AdhamHamdy03/Final-Project-Bachelor-DTMF-Ultrasound-Autonomous-Robot-etc-./rendu 1 /BASE_GR11.pdf

## BASE_GR11

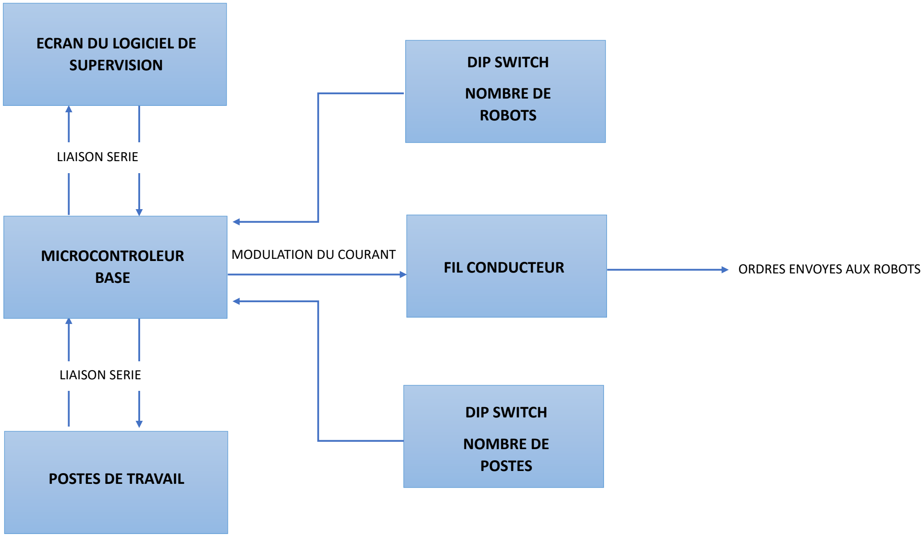
[picture p1: figure]
MICROCONTROLEUR BASE; ECRAN DU LOGICIEL DE SUPERVISION; POSTES DE TRAVAIL; FIL CONDUCTEUR; MODULATION DU COURANT; ORDRES ENVOYES AUX ROBOTS; LIAISON SERIE; DIP SWITCH; NOMBRE DE POSTES; NOMBRE DE ROBOTS
