AdhamHamdy03/Final-Project-Bachelor-DTMF-Ultrasound-Autonomous-Robot-etc-./rendu 1 /POSTE_GR11.pdf

# Poste_Gr11

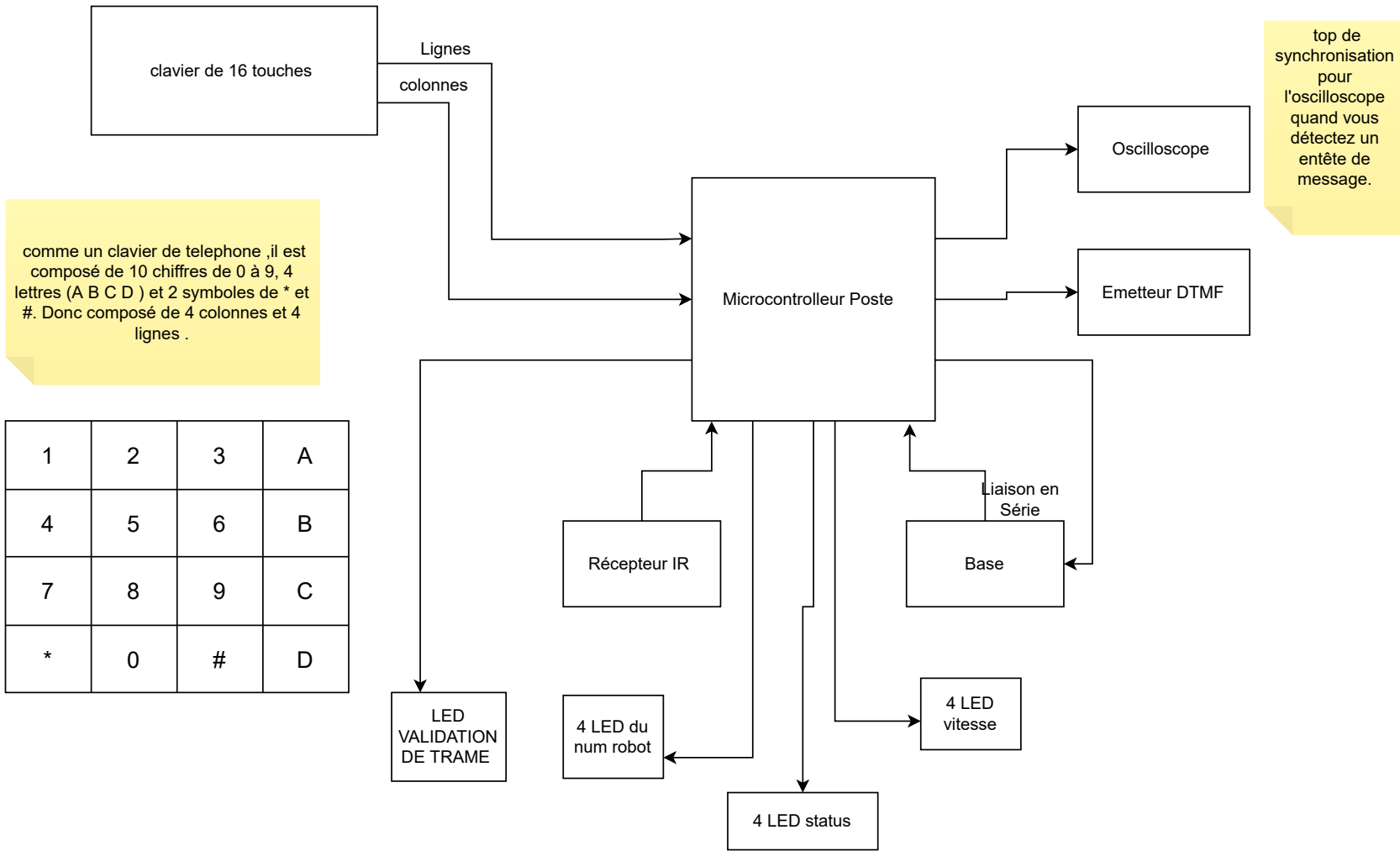
[picture p2: figure]
Microcontrolleur Poste; clavier de 16 touches; Lignes; colonnes; Emetteur DTMF; Récepteur IR; Base; Liaison en Série; LED VALIDATION DE TRAME; 4 LED du num robot; Oscilloscope; top de synchronisation pour l'oscilloscope quand vous détectez un entête de message.; comme un clavier de telephone ,il est composé de 10 chiffres de 0 à 9, 4; #. Donc composé de 4 colonnes et 4 lignes .; 4 LED status; 4 LED vitesse

lettres (A B C D ) et 2 symboles de * et

status :
0x8 "disponible" ,0x4 "enlèvecolis", 0x2 "colispris", 0x1 "livraison"
