AdhamHamdy03/Final-Project-Bachelor-DTMF-Ultrasound-Autonomous-Robot-etc-./rendu 1 /STATUS_GR11.pdf

STATUS_GR11 | Code C associé au grafcet :
| void status_grafcet(void){
| static unsigned char pos_jeton = 1;
| switch(pos_jeton)
| {
| case 1: // Status « disponible »- attente d’une demande de livraison
| if(flag_delivery_assigned){ pos_jeton++; }
| break;
| case 2: // Status « enlèvecolis » – en route au poste de pickup colis
| if(Robot_at_poste_pickup) { stop(); }
| else { move(); }
| if(flag_leave_pickup) { pos_jeton++;}
| break;
| case 3: // Status « colispris » – attente transmission du poste dropoff
| move();
| if(flag_assigned_dropoff) { assign_dropoff_poste(); pos_jeton++;}
| break;
| case 4: // Status « livraison » – en route au poste de dropoff colis
| if(Robot_at_poste_dropoff) { stop(); }
| else { move(); }
| if(flag_leave_dropoff) { pos_jeton = 1; }
| }
| }

move

flag_leave_dropoff

move | stop

!(Robot_at_poste_dropoff) Robot_at_poste_dropoff

flag_leave_pickup

assign_dropoff_poste

1

2

3

4

flag_delivery_assigned

move | stop

!(Robot_at_poste_pickup) Robot_at_poste_pickup

move
