AdhamHamdy03/Final-Project-Bachelor-DTMF-Ultrasound-Autonomous-Robot-etc-./rendu 2/WBS_GR11.pdf

# Tâches

# Lots de tâches

# Sous-projets

Projet | Infrastructure Autonome de livraison

Préparation

1er rendu

# SUPER_GR11 ROBOT_GR11 COM_GR11 POSTE_GR11 BASE_GR11

STATUS_GR11 PHYSIQUE_GR11 Validation des documents Rendu des documents a l'équipe pédagogique

Livrable : Documents qui sert à préparer le 2ème rendu

2ème rendu Bilan ES Base Bilan ES Poste Bilan ES Robot WBS Matrice RACI Validation des documents Rendu des documents a l'équipe pédagogique

Livrable : Organisation du projet et répartition des tâches entre les membres de l'équipe

Base
Liaison série avec la Supervision Choix du protocole de communication Initialisation et configuration des registres Gestion des interruptions et buffers Validation par simulation série sur KEIL

Livrable : Visualisation du status de chaque robot et requêtes des postes

Liaison série avec les Postes Choix du protocole de communication

Initialisation et configuration des registres Gestion des interruptions et buffers Tests avec simulateur de poste ou terminal série

Livrable : Routine de demande informations aux postes

Emission signal modulé dans le fil Schéma électrique Conception du circuit émetteur (oscillateur + amplificateur) Choix de la fréquence de modulation Génération du signal via PWM microcontrôleur Codage des instructions Test sur fil conducteur avec oscilloscope Vérification de la lisibilité et de l’intégrité du signal Livrable : Signal de commande des robots

Poste

Liaison série avec la base Choix du protocole de communication

Initialisation et configuration des registres Gestion des interruptions et buffers Tests avec simulateur liaison série sur KEIL

Livrable : Status des robots et requêtes des postes

Réception IR
Schéma électrique Choix du capteur Montage physique orienté vers la trajectoire du robot Filtrage matériel (fréquence porteuse) Décodage du signal IR (ID, vitesse, status robot) Validation de la trame (entête, checksum) Test en conditions réelles avec robot approchant Livrable : Signal IR capté qui vient du robot et qui indique son ID, sa vitesse et son status

Émission DTMF

Schéma électrique Codage signal DTMF sur microcontrôlleur du poste

Implémentation de la génération DTMF par interpolation

Tests de reconnaissance côté base avec décodeur Livrable : Signal DTMF à envoyé au robot avec le numéro de poste encodé

Robot Assamblage robot Schéma électrique et câblage Conception du châssis Emplacement des capteurs (IR, bobines, DTMF, proxymetre) Fixation des modules (IR, moteurs, labdec) Test robustesse

Livrable : Structure physique du robot

# Alimentation Choix composants Schéma électrique Convertisseur de tension

Système coupe de poing Mesure de tension et validation

Livrable : Alimentation des modules du robot

Capteur inductif - Suivi du fil Conception des bobines de réception

Schéma électrique Câblage du circuit Lecture du signal modulé (via ADC) Synchronisation de la prise de mesure avec le microcontrôleur Calcul de l'amplitude du signal -> calcul de la distance Algorithme de suivi ligne (centrage, virage) Test sur piste avec fil au sol Livrable : Distance entre le fil et le robot, à utiliser pour le piloter

Système contrôle du moteur/des roues Choix des moteurs (DC, pas-à-pas) Dimensionnement puissance, couple

Schéma électrique Pilotage par H-Bridge Génération PWM et commande direction Régulation vitesse/direction (PID si nécessaire) Développement du code embarqué

Tests sur simulateur et sur robot après implémentation

Livrable : Pilotage du robot

Mésure de la distance parcouroue Choix de carte FPGA

Liaision SPI avec le microcontrôlleur du robot Codeurs incrémentaux des moteurs Programmation de la carte FPGA et du microcontrôlleur Tests sur simulateur série KEIL et simulateur Vivado

Livrable : Distance parcourue

Système détection obstacles Schéma électrique Choix du capteur Fixation frontale sur robot Lecture périodique du capteur Définition seuil critique de distance Déclenchement arrêt ou évitement Haut Parleur - message audio de prevention

Implémentation routine d’arrêt d’urgence

Tests sur simulateur KEIL

Livrable : Prevention des accidents sur la route

Émission IR
Schéma électrique Choix LED IR (intensité, angle émission) Choix Fréquence de modulation Création de trame à envoyer (entête, ID, vitesse, status) Émission cyclique (timer) Synchronisation de la prise de mesure avec le microcontrôleur Tests sur simulateur KEIL

Livrable : Signal IR envoyé au poste avec l'ID, la vitesse et le status du robot

Réception DTMF

Schéma électrique
Intégration circuit de décodage DTMF Détection de tonalités (via interruption ou polling) Décodage vers commande de destination

Stockage ou traitement immédiat Test du module

Livrable : reconnaissance du poste qu'il détecte
