AdhamHamdy03/Final-Project-Bachelor-DTMF-Ultrasound-Autonomous-Robot-etc-./schemas 2/GR11_SchemaElec.pdf

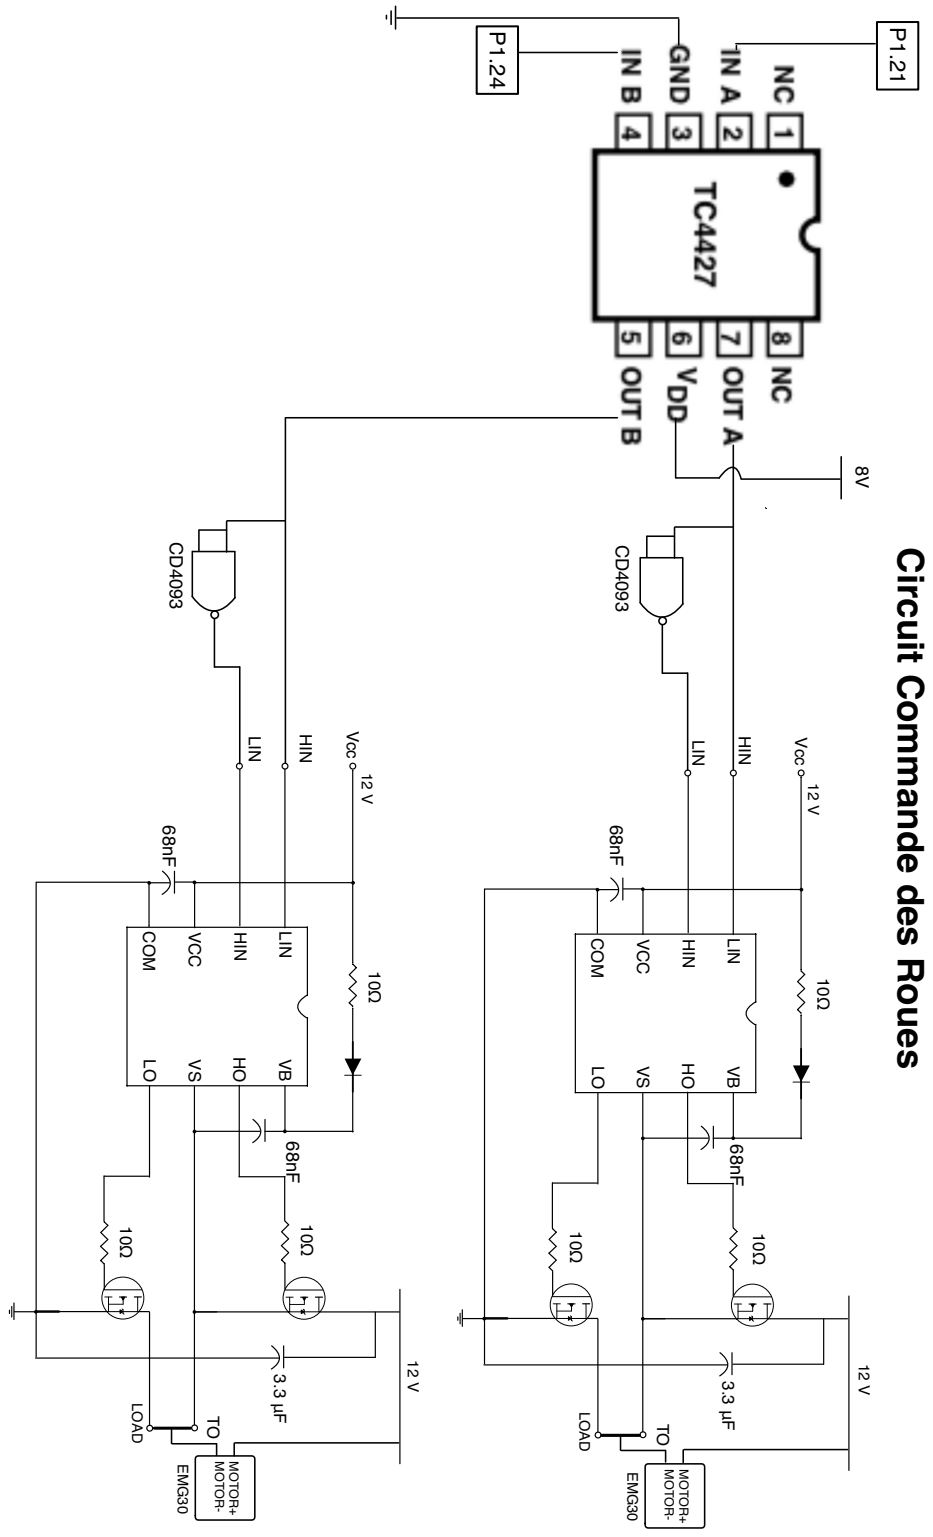
[picture p3: page 1]
COM; VCC; HIN; LIN; Vcc; LOAD; EMG30; MOTOR-; MOTOR+

P1.21 Circuit Commande des Roues

## Circuit Courant modulé

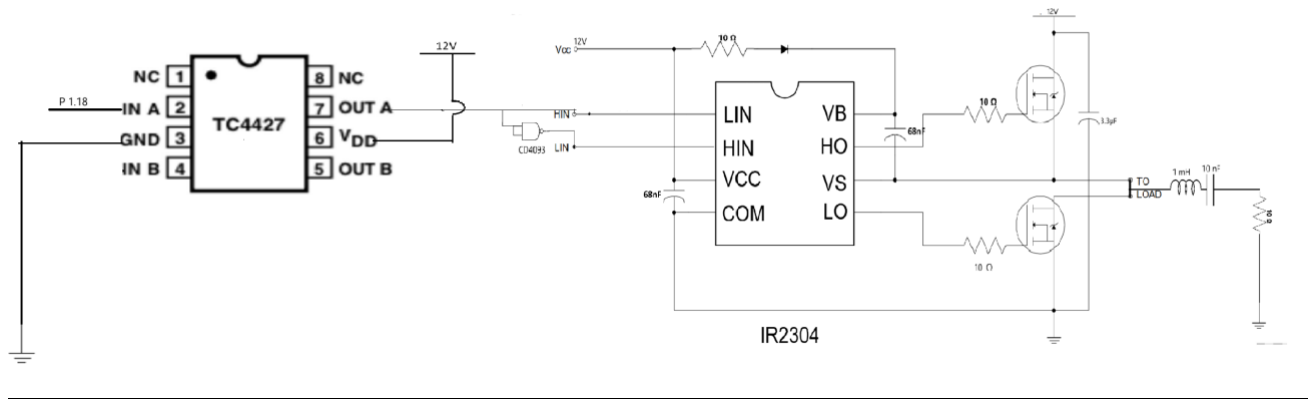
[picture p4: figure]

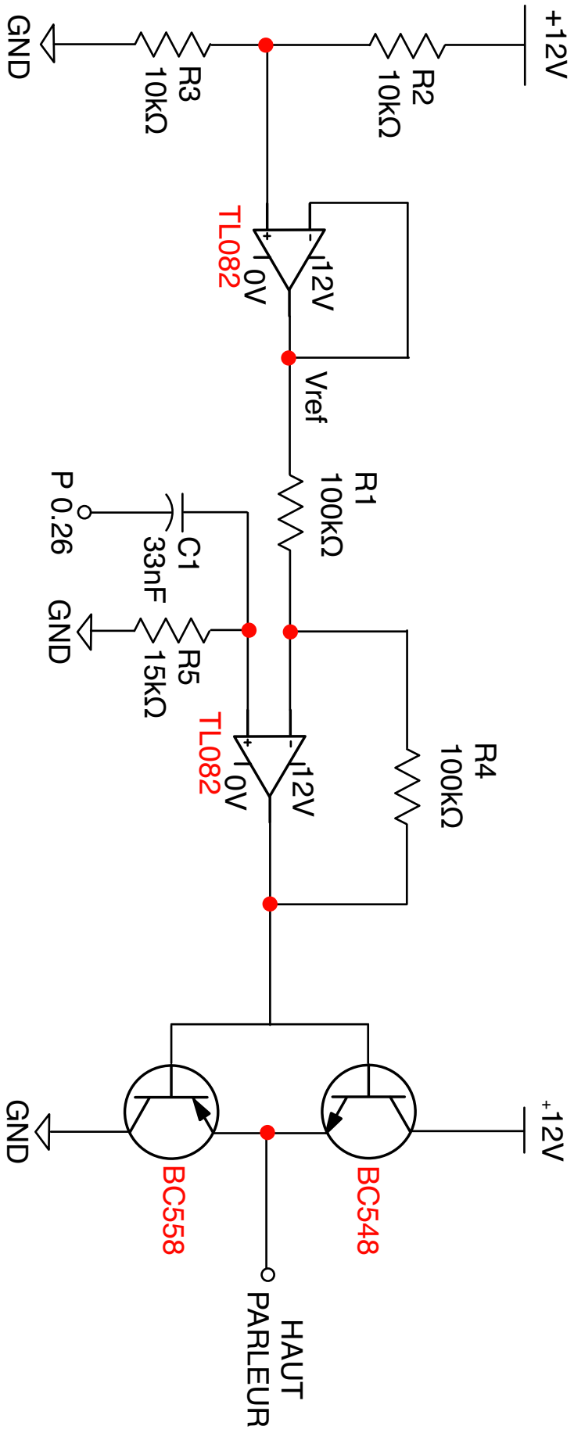
[picture p5: figure]
GND; HAUT; PARLEUR; Vref

## Emission DTMF

# Émission Infrarouge

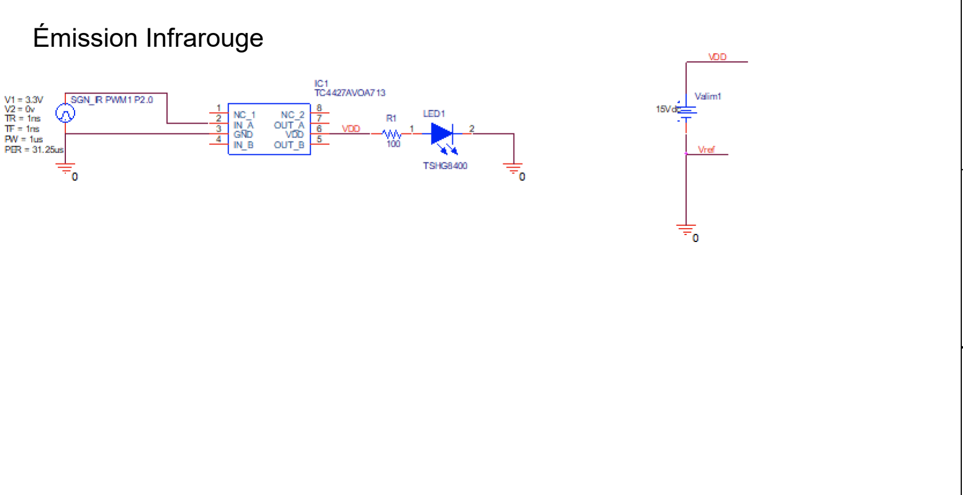
[picture p6: page 4]

# Réception Infrarouge

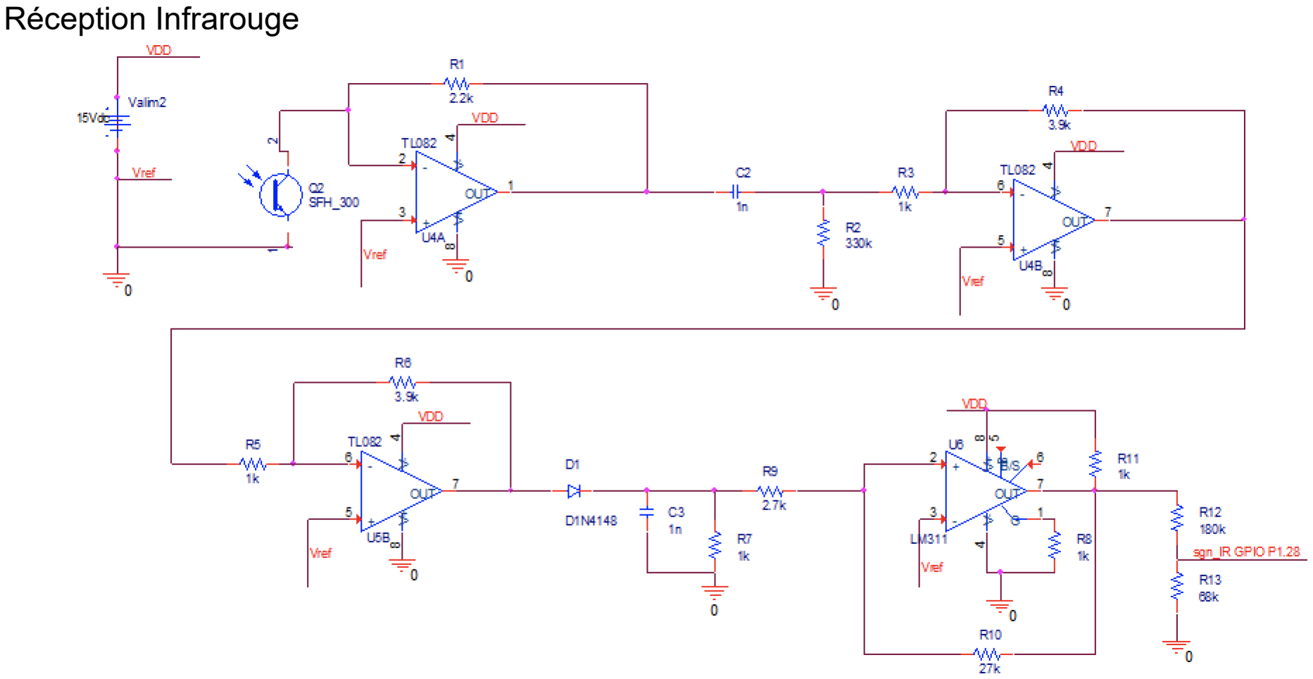
[picture p7: page 5]

# Mesure de distance

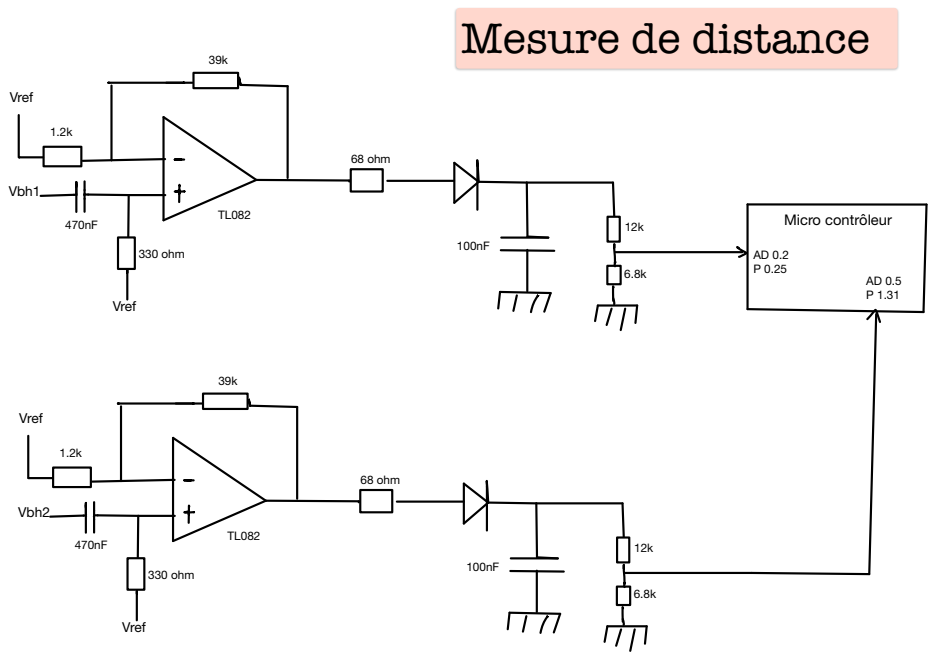
[picture p8: page 6]
Micro contrôleur; Vref; Vbh1; 330 ohm; 68 ohm; Vbh2

### Xor1

# Orientation du robot par rapport

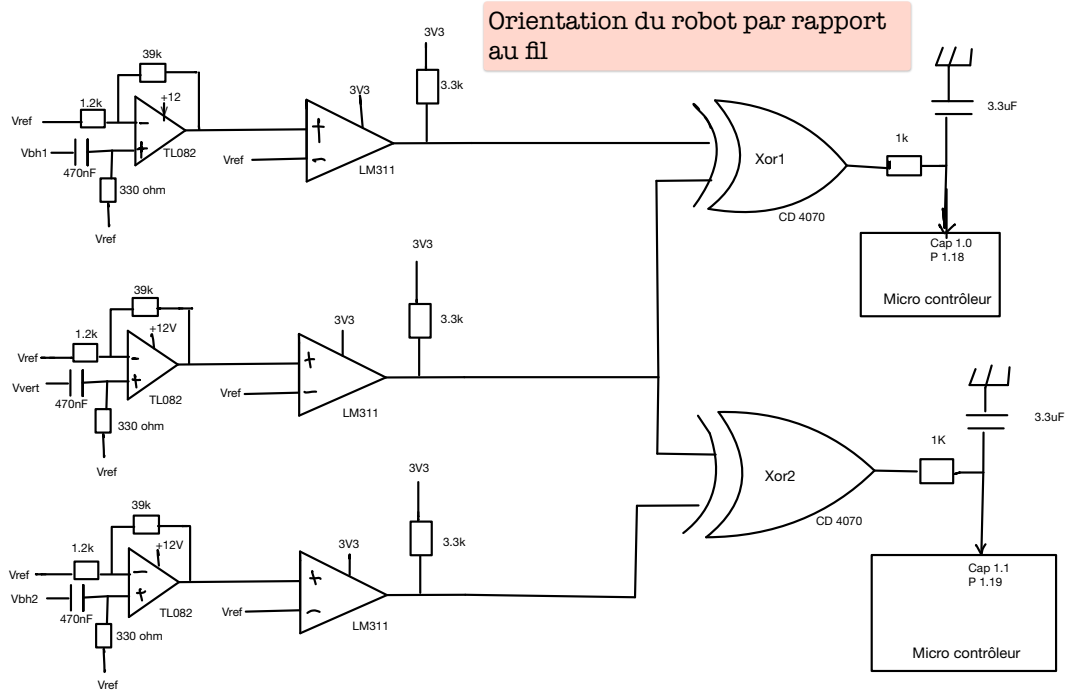
[picture p9: page 7]
Cap 1.0 P 1.18; Cap 1.1 P 1.19; Micro contrôleur; 330 ohm; Vbh1; Vref; Vbh2; Vvert; Xor2; au fil

# Lecture du message reçu par la base

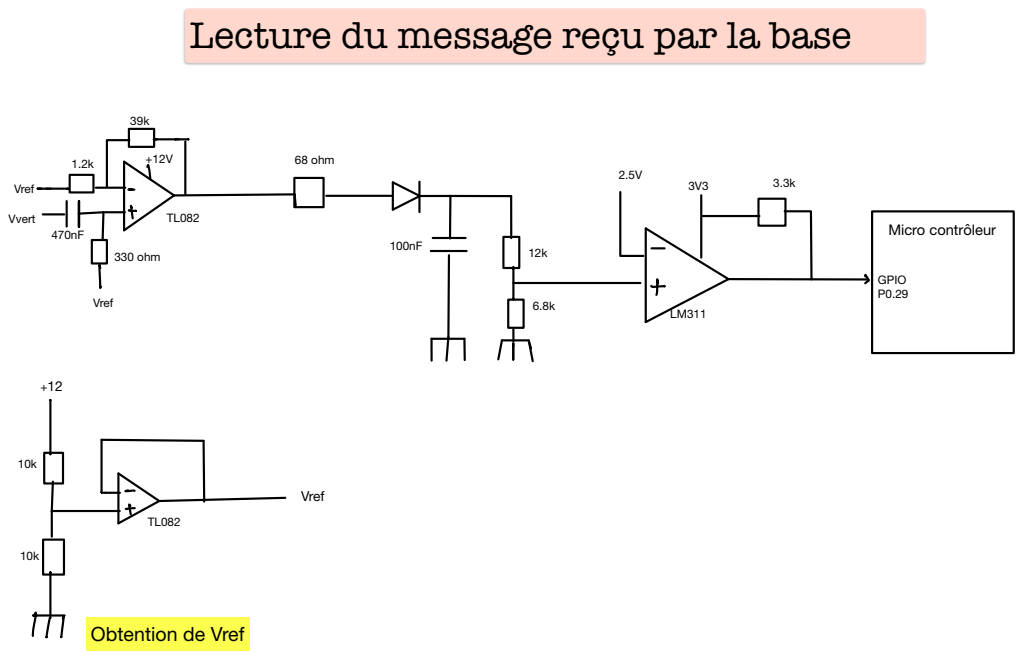
[picture p10: page 8]
330 ohm; Vref; Vvert; 68 ohm; Micro contrôleur; GPIO P0.29

Obtention de Vref

## Réception DTMF :

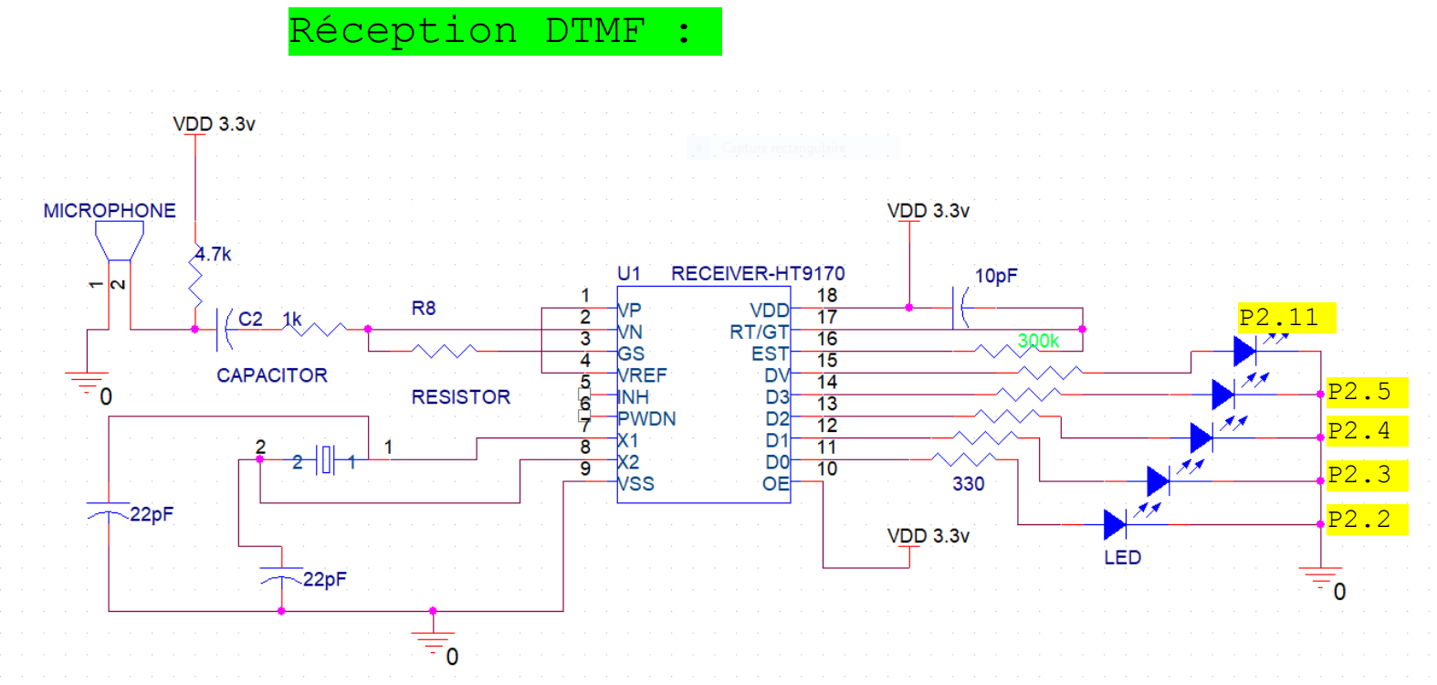
[picture p11: page 9]

P2.11

P2.5

P2.3

P2.2

P2.4

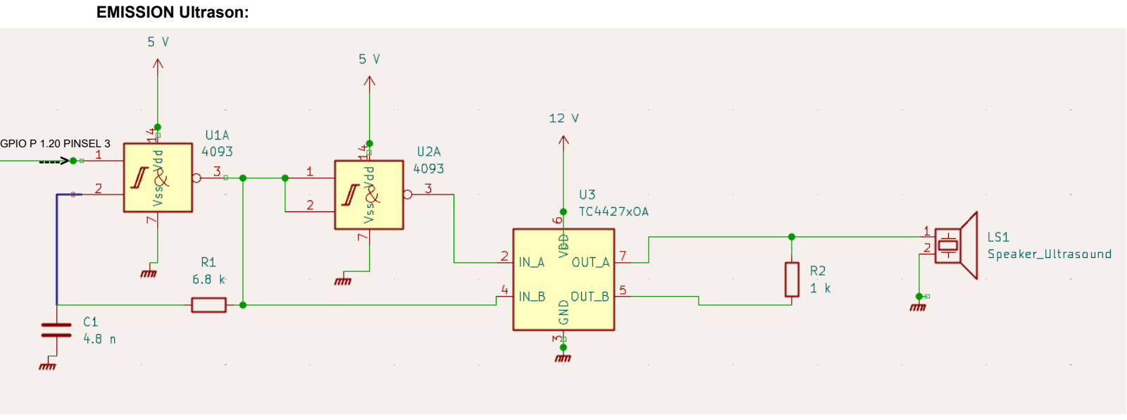
[picture p12: page 10]

EMISSION Ultrason:

GPIO P 1.20 PINSEL 3
---->

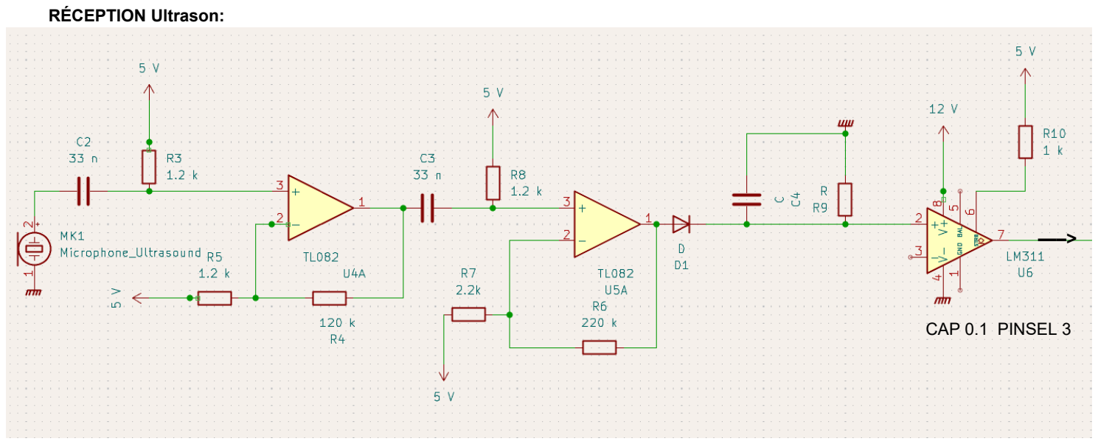
[picture p13: page 11]

RÉCEPTION Ultrason:

—–>

CAP 0.1 PINSEL 3

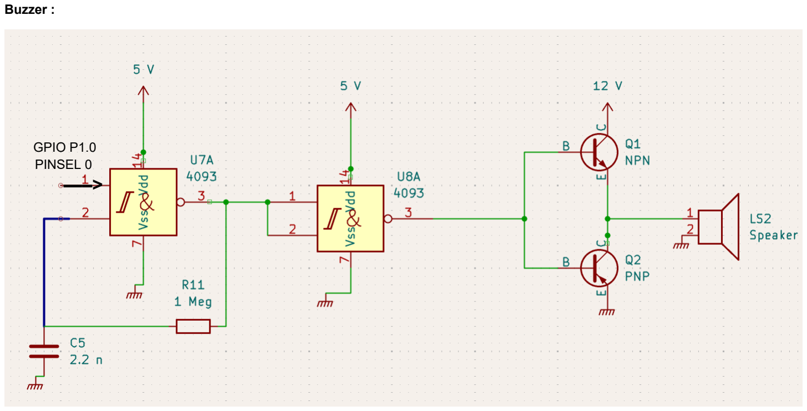
[picture p14: page 12]

Buzzer :

GPIO P1.0
PINSEL 0
—–>
