AdhamHamdy03/Final-Project-Bachelor-DTMF-Ultrasound-Autonomous-Robot-etc-./schema et travail/reception dtmf jana .pptx

Réception DTMF :

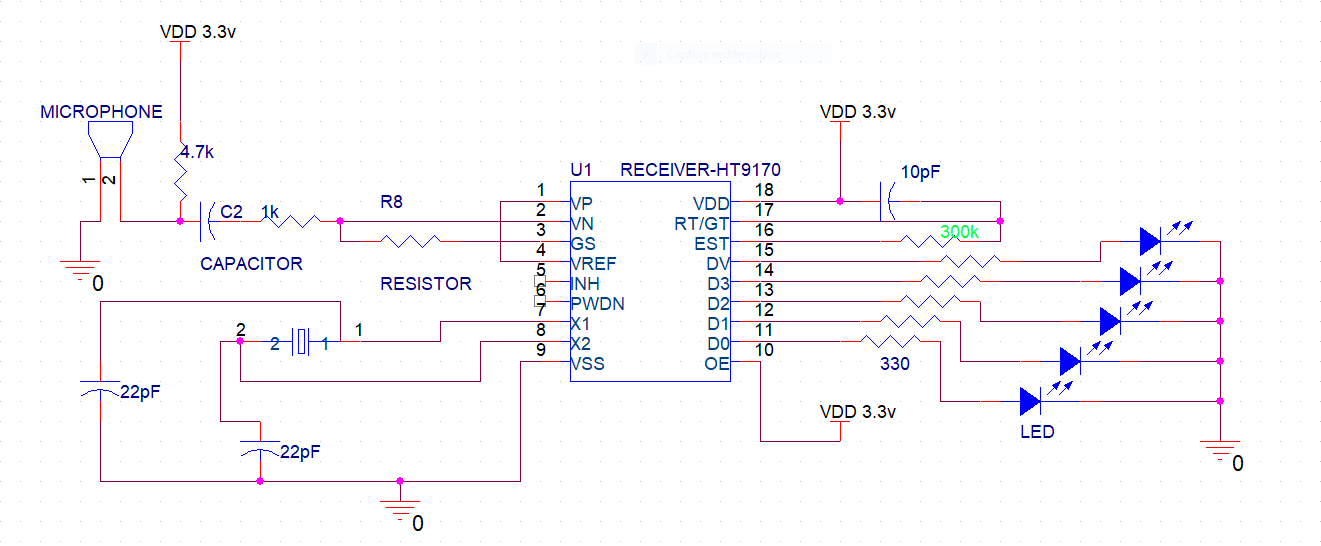
[picture p15: figure]

P2.11

P2.5

P2.4

P2.3

P2.2

## Schéma block Emission DTMF :

Filtrage des bases frequences jusqu’à 5 KHz

Amplification de tension de gain =3

Amplification de puissance

Signal sortie et haut parleur

Signal d’entrée

## Schema Etat reception DTMF

READ_HASH

READ_A

Code==12

Code==11

Code<=10

Code==13

READ_STAR

READ_DIGIT

## Reception DTMF

Signal reçue

Microphone

Filtrage

Message codé en 4 bits

P2.2
P2.3
P2.4
P2.5

Amplification
Gain =100

Décodage

Validation de trame

P2.11
