AdhamHamdy03/Final-Project-Bachelor-DTMF-Ultrasound-Autonomous-Robot-etc-./rendu 1 /COM_GR11.pdf

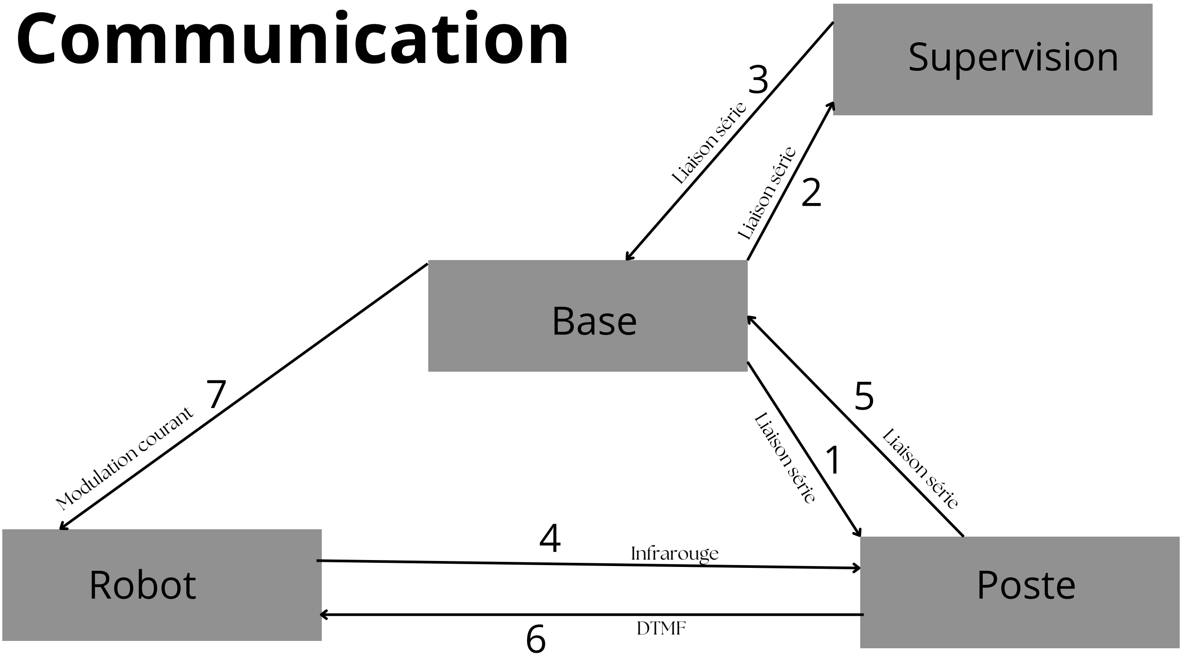
[picture p16: figure]
Base; Robot; Supervision; Poste; Liaison série; Infrarouge; DTMF; Modulation courant; Communication

1
2
3

4
5

6

7

La base interroge le poste sur son état

Transmission des informations sous la forme d’un message du type PxxRyvZ pour l’affichage de l’écran de supervision
L’écran de supervision envoie à la base des messages d’attribution de mission du type RxxPyy-Pzz et la base récupère les vitesses et numéros de robots affichés (RxxVyy)

Transmission de l’identifiant du robot au poste sous forme d’un trame infrarouge

Le poste génère un code DTMF permettant à un robot qui lui passe devant d’identifier son numéro

Réponse du poste à la base avec la transmission des informations du robot

En modulant le courant, la base va avertir les robots et leurs donner des missions ainsi qu’assurer l’asservissement du trajectoire et donc le suivi du fil
