AdhamHamdy03/Final-Project-Bachelor-DTMF-Ultrasound-Autonomous-Robot-etc-./rendu 1 /PHYSIQUE_GR11.pdf

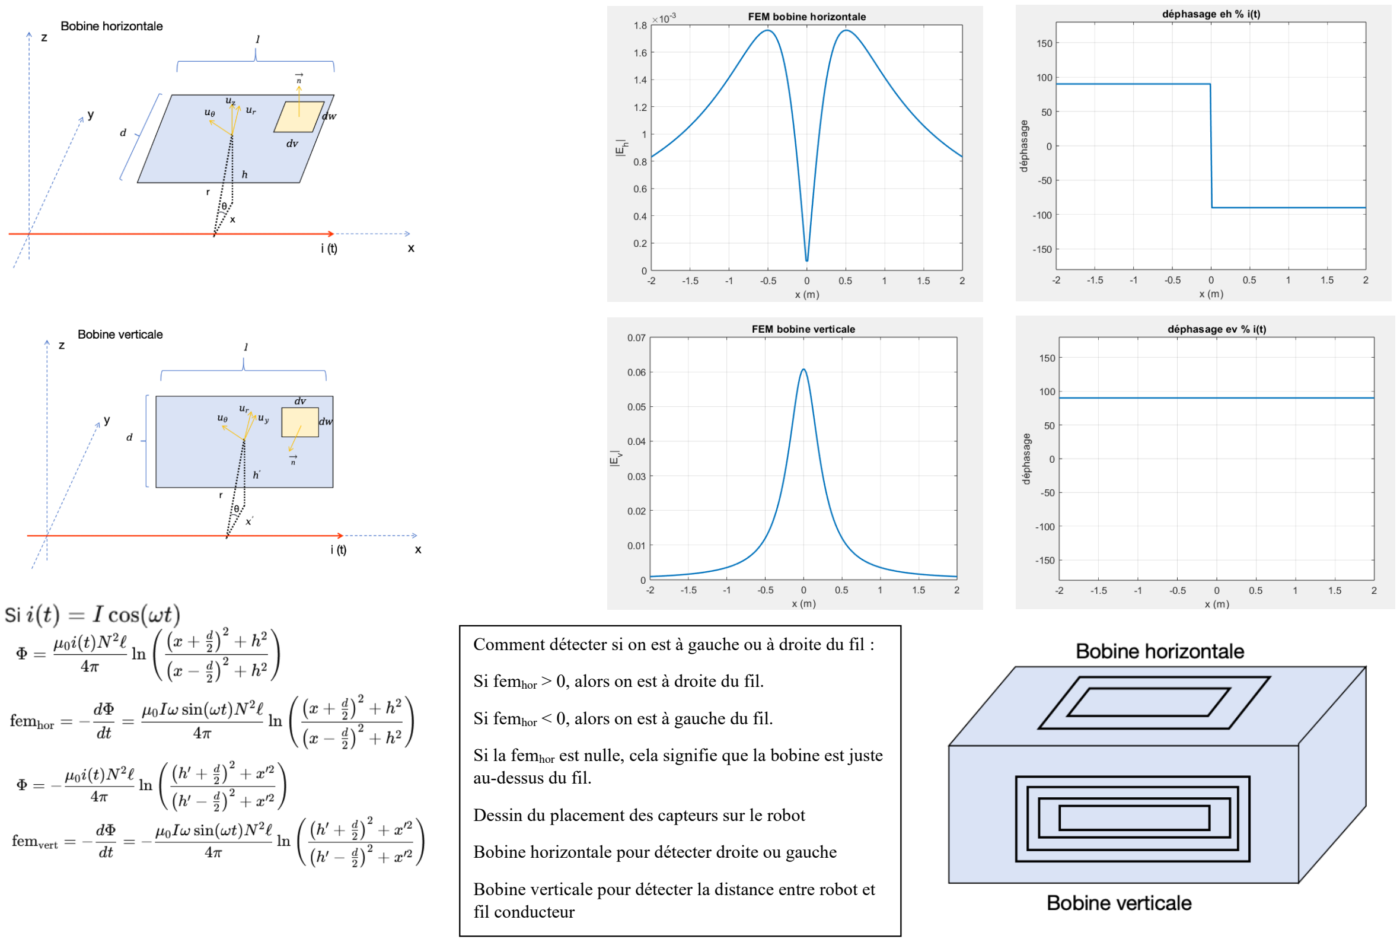
[picture p17: page 1]

Comment détecter si on est à gauche ou à droite du fil :

Si femhor > 0, alors on est à droite du fil.

Si femhor < 0, alors on est à gauche du fil.

Si la femhor est nulle, cela signifie que la bobine est juste au-dessus du fil.

Dessin du placement des capteurs sur le robot

Bobine horizontale pour détecter droite ou gauche

Bobine verticale pour détecter la distance entre robot et fil conducteur

### Démarche pour calculer :

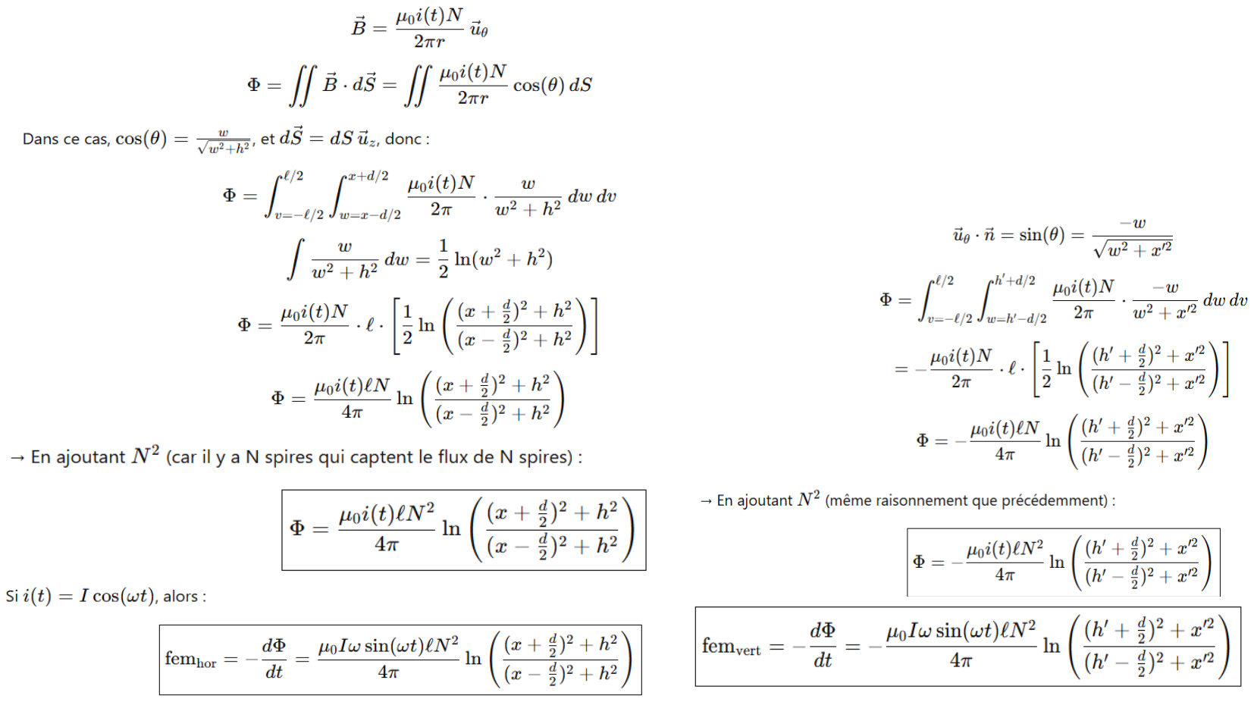
[picture p18: figure]
