AdhamHamdy03/Final-Project-Bachelor-DTMF-Ultrasound-Autonomous-Robot-etc-./rendu 1 /SUPER_GR11.pdf

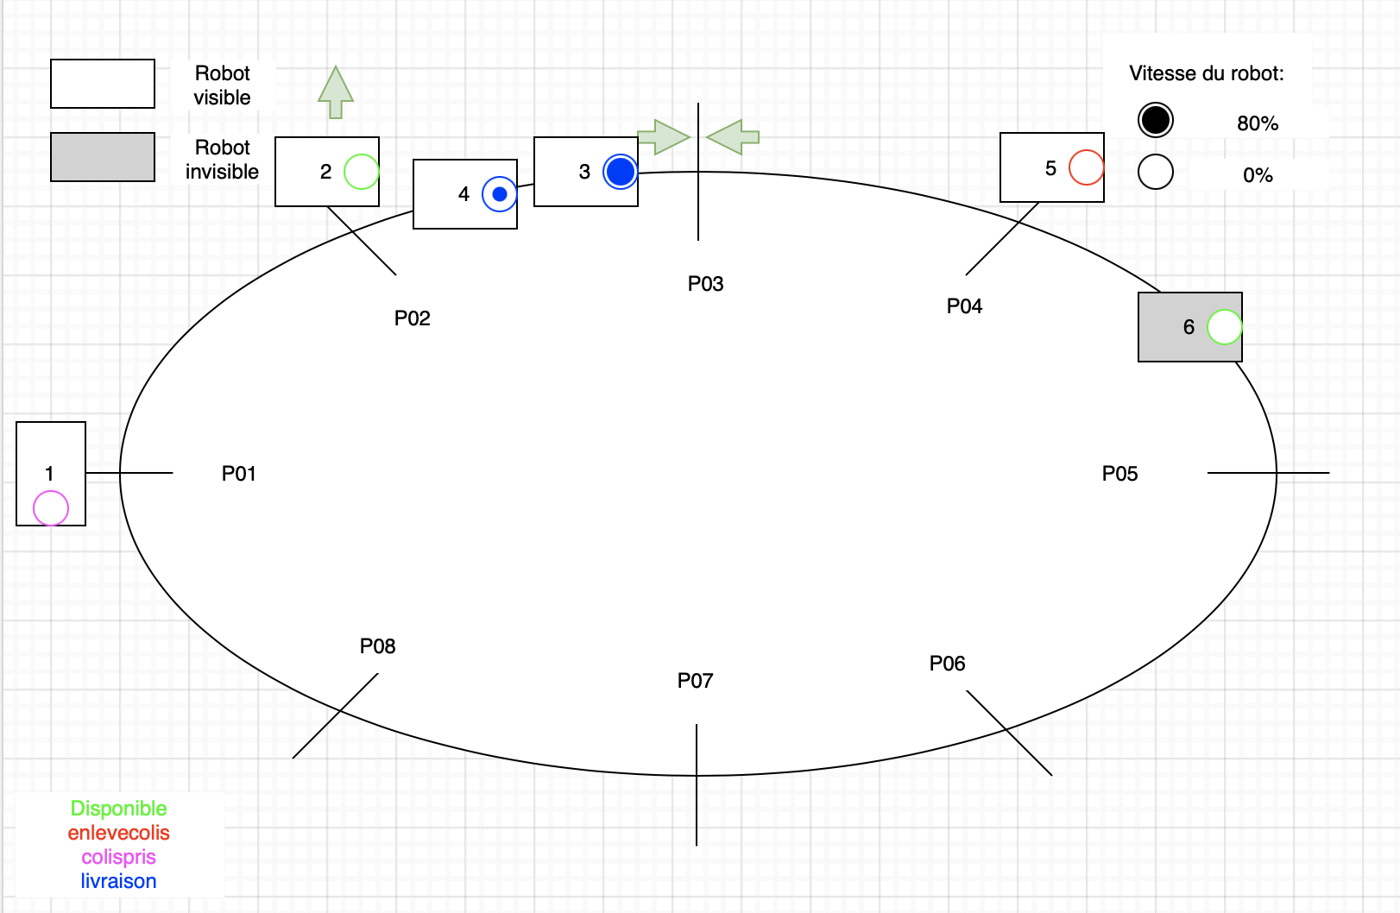
[picture p19: figure]

### tableau dynamique

Liste trajets | Numéro de robot affecté à la mission | Identifiant | Dernier status
P01 -> P08 | 1 | A | C
P01 -> P02 | 2 | B | D
P01 -> P03 | 3 | C | L
P01 -> P04 | 4 | C | L
P04 -> P06 | 5 | D | E
P01 -> P06 | ？ | B | ?

[D] disponible
└──▶ [E] enlèvecolis
└──▶ [C] colispris
└──▶ [L] livraison
└──▶ [D] disponible (sortie)
