AdhamHamdy03/Final-Project-Bachelor-DTMF-Ultrasound-Autonomous-Robot-etc-./schema et travail/reception dtmf  .pdf

## Réception DTMF :


P2.11

P2.5

P2.3

P2.2

P2.4
