AdhamHamdy03/Final-Project-Bachelor-DTMF-Ultrasound-Autonomous-Robot-etc-./schemas 2/telemetre Ultrason et buzzer 2.pdf

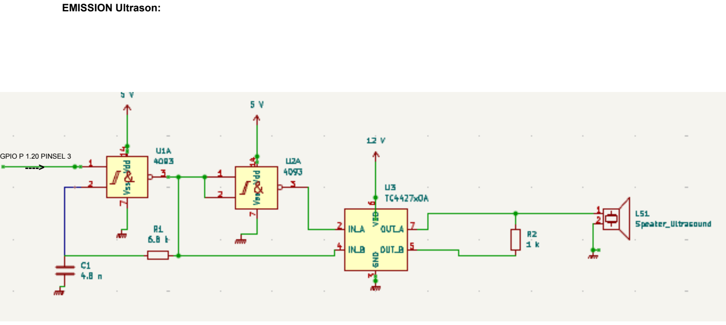
[picture p20: page 1]

EMISSION Ultrason:

GPIO P 1.20 PINSEL 3
---->

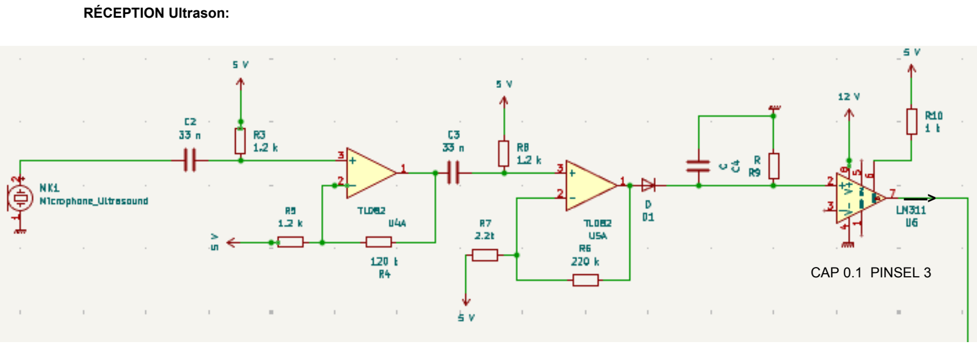
[picture p21: page 2]

RÉCEPTION Ultrason:

—–>

CAP 0.1 PINSEL 3

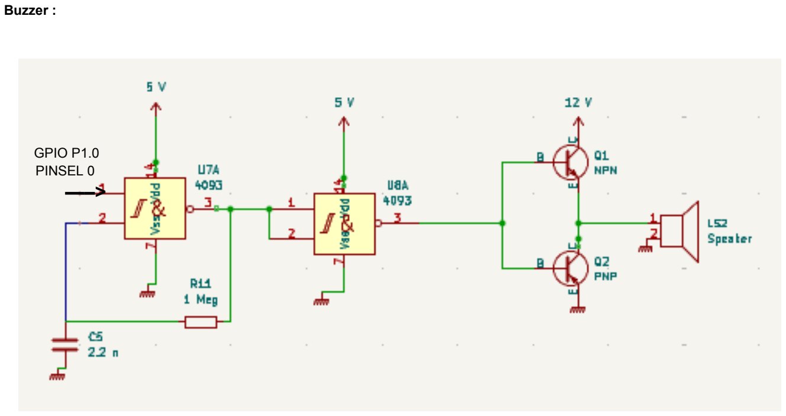
[picture p22: page 3]

Buzzer :

GPIO P1.0
PINSEL 0
—–>
