AdhamHamdy03/Final-Project-Bachelor-DTMF-Ultrasound-Autonomous-Robot-etc-./schemas 2/telemetre Ultrason et buzzer 3.pdf

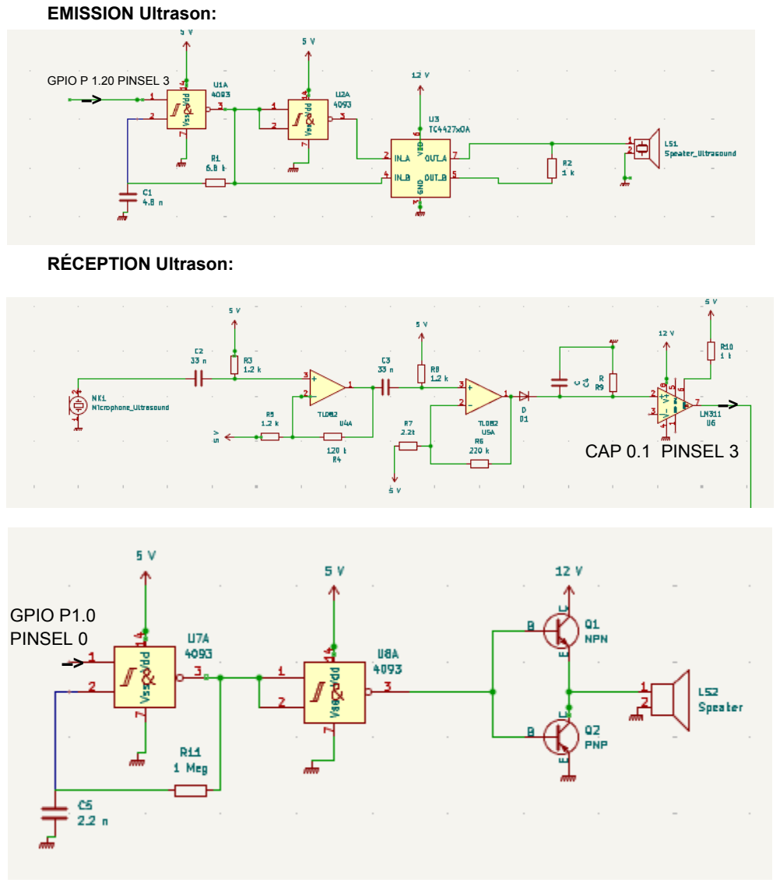
[picture p23: page 1]

EMISSION Ultrason:

GPIO P 1.20 PINSEL 3
–>

RÉCEPTION Ultrason:

–>

CAP 0.1 PINSEL 3

GPIO P1.0
PINSEL 0
–>
