AdhamHamdy03/Final-Project-Bachelor-DTMF-Ultrasound-Autonomous-Robot-etc-./support mic v3.stl

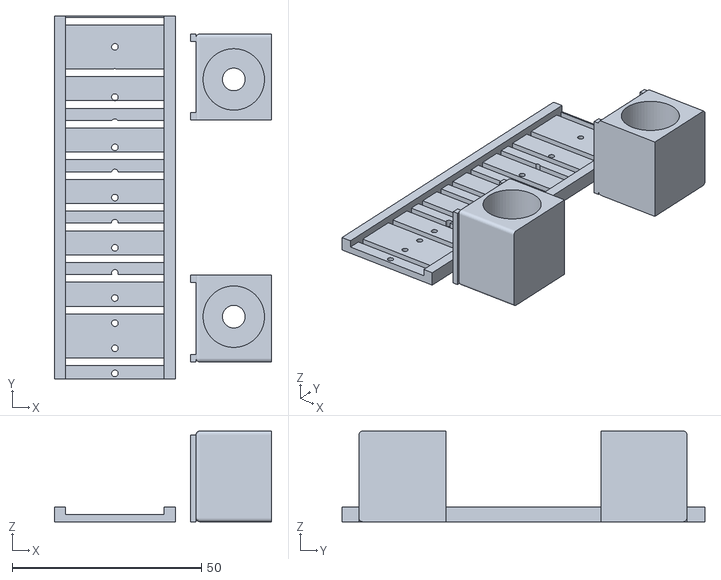
[picture p24: CAD file, 2026-06-16]
support mic v3.stl
57.4 x 96.0 x 24.1
