AdhamHamdy03/Final-Project-Bachelor-DTMF-Ultrasound-Autonomous-Robot-etc-./rendu 1 /ROBOT_GR11.pdf

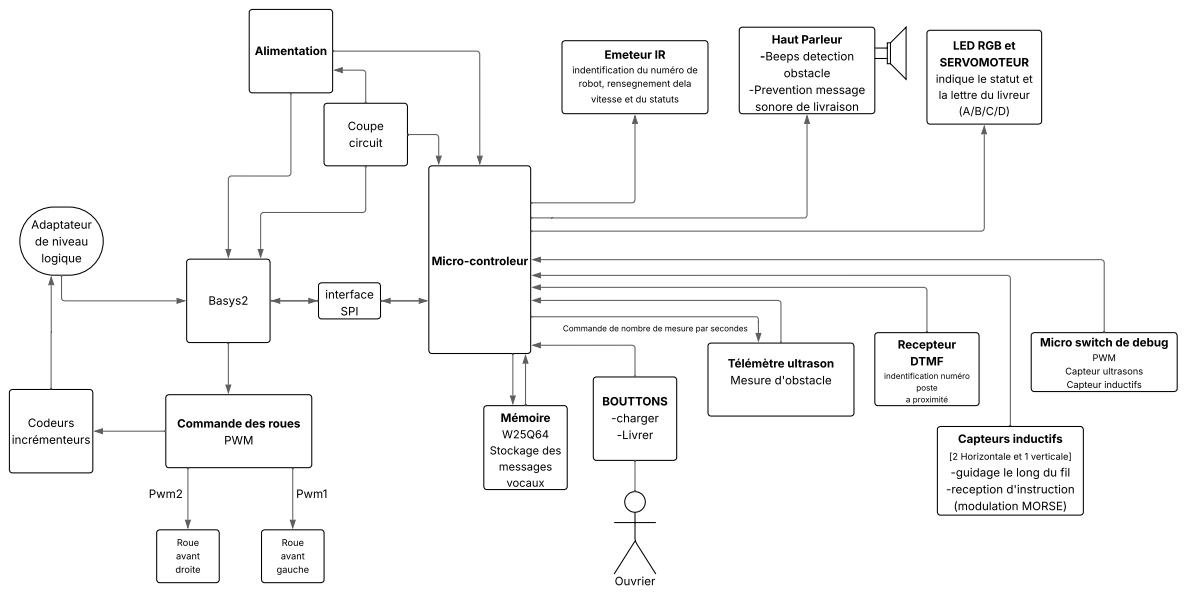
[picture p25: page 1]
Alimentation; Micro- controleur; BOUTTONS - charger -Livrer; Ouvrier; Recepteur DTMF; indentification numéro poste a proximité; Télémètre ultrason Mesure d'obstacle; PWM; Roue avant droite; Roue avant gauche; Pwm2; Pwm1; Basys2; Codeurs incrémenteurs; Adaptateur de niveau logique; Coupe circuit; Mémoire W25Q64 Stockage des messages vocaux; interface SPI; PWM Capteur ultrasons Capteur inductifs

Haut Parleur
-Beeps detection
obstacle
-Prevention message
sonore de livraison

LED RGB et
SERVOMOTEUR
indique le statut et
la lettre du livreur

Emeteur IR
indentification du numéro de
robot, rensegnement dela
vitesse et du statuts

Commande de nombre de mesure par secondes

Micro switch de debug

Commande des roues

Capteurs inductifs
[2 Horizontale et 1verticale]
-guidage le long du fil
-reception d'instruction
(modulation MORSE)
