AdhamHamdy03/Final-Project-Bachelor-DTMF-Ultrasound-Autonomous-Robot-etc-./schemas 2/Préparation_merged 2.pdf

# Mesure de distance

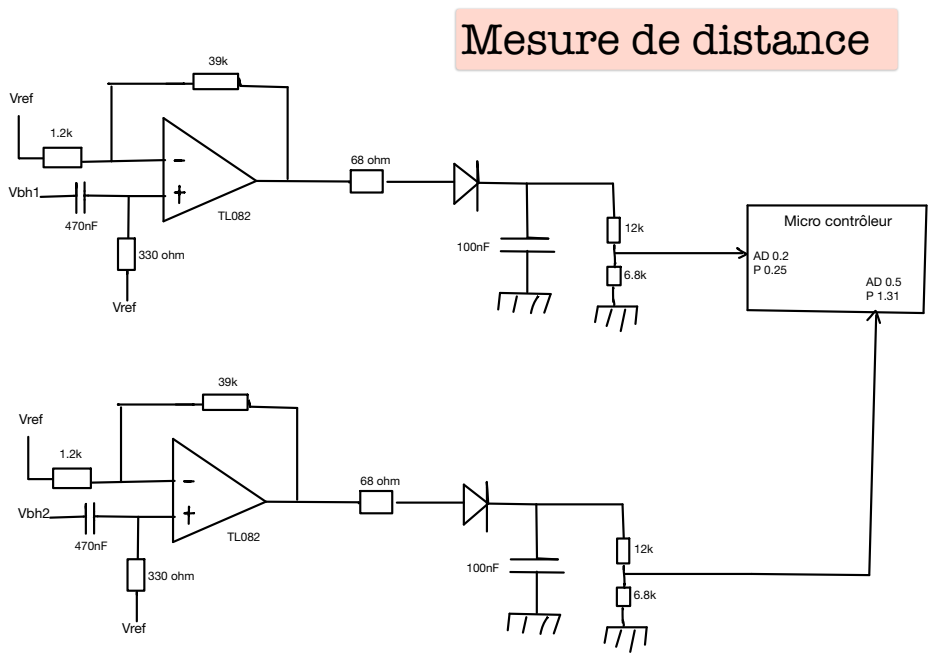
[picture p26: page 1]
Micro contrôleur; Vref; Vbh1; 330 ohm; 68 ohm; Vbh2

# Orientation du robot par rapport au fil

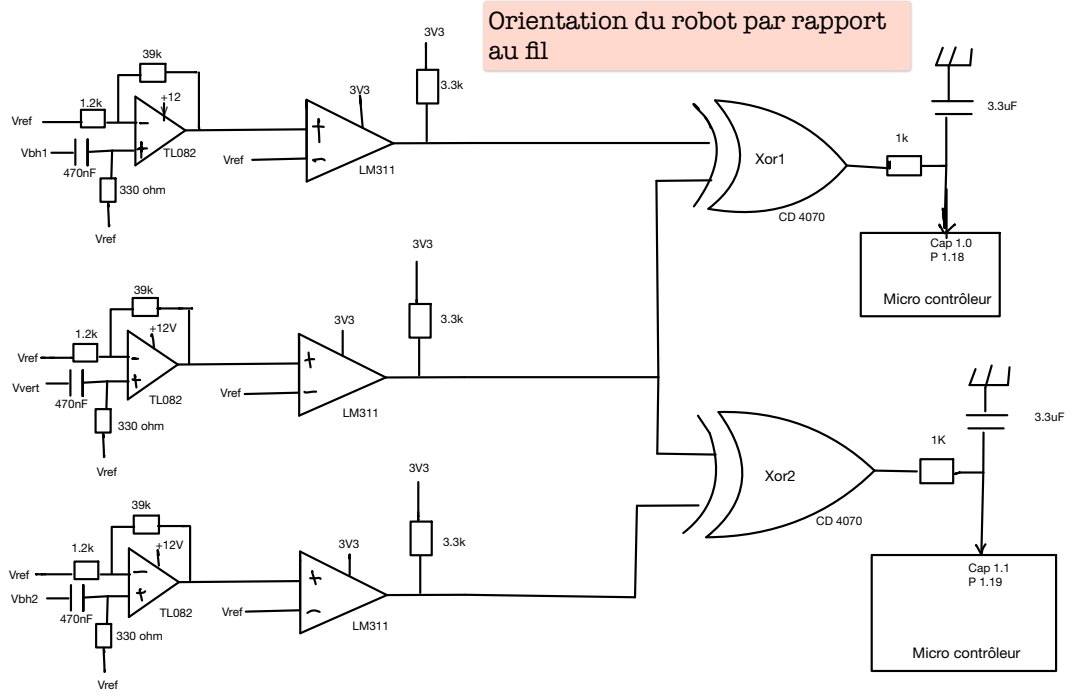
[picture p27: page 2]
Cap 1.0 P 1.18; Cap 1.1 P 1.19; Micro contrôleur; 330 ohm; Vbh1; Vref; Vbh2; Vvert; Xor1; Xor2

# Lecture du message reçu par la base

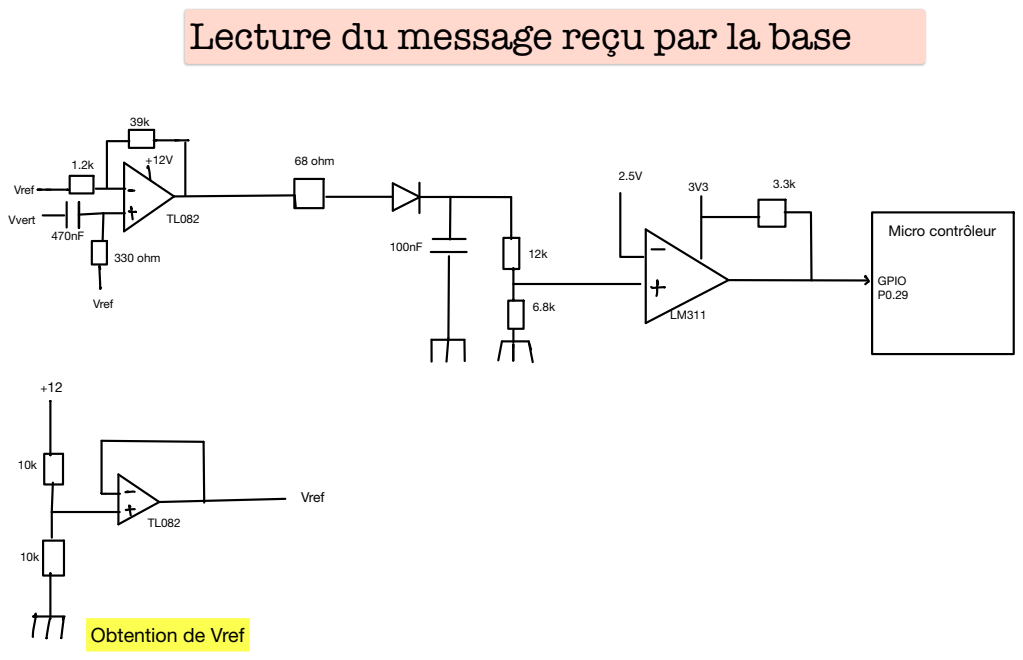
[picture p28: page 3]
330 ohm; Vref; Vvert; 68 ohm; Micro contrôleur; GPIO P0.29

Obtention de Vref
