AdhamHamdy03/Final-Project-Bachelor-DTMF-Ultrasound-Autonomous-Robot-etc-./schemas 2/Préparation_merged.pdf

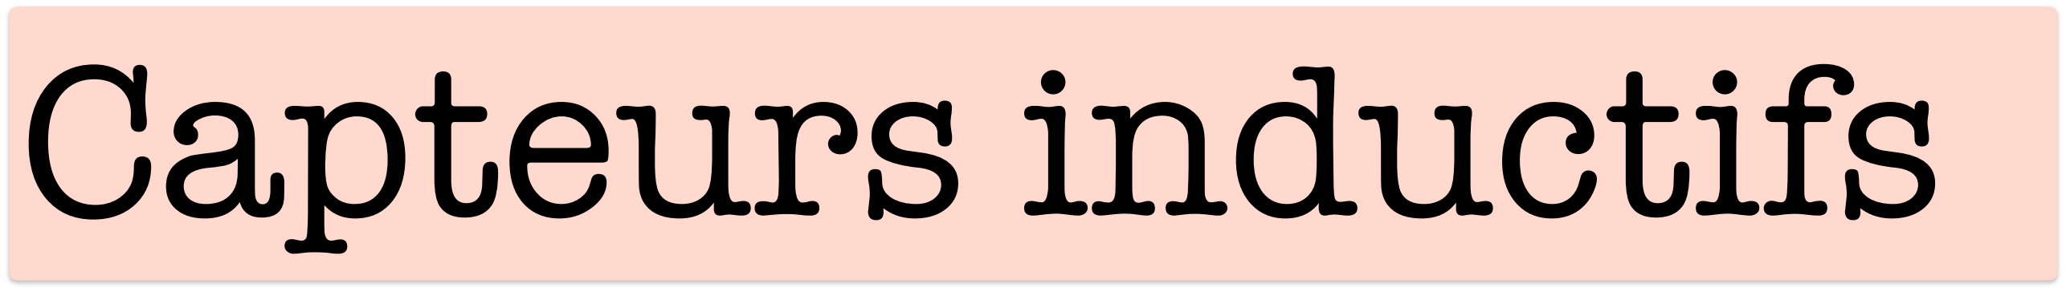
[picture p29: figure]
Capteurs inductifs

# Mesure de distance

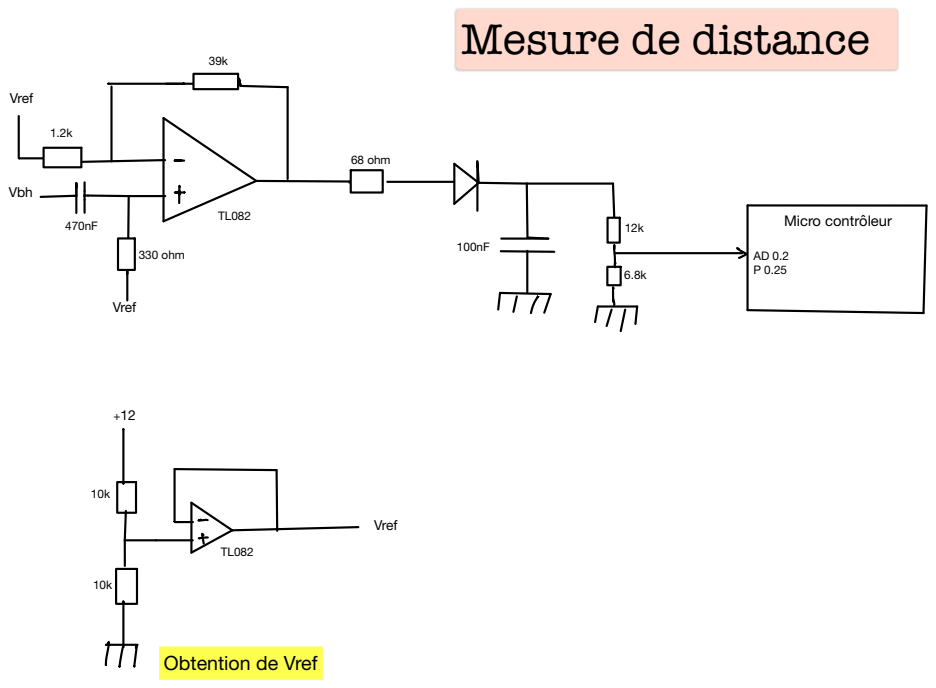
[picture p30: page 2]
Micro contrôleur; Vref; Vbh; 330 ohm; 68 ohm

Obtention de Vref

# Orientation du robot par rapport au fil

Cap 1.0 P 1.18; Cap 1.1 P 1.19; Micro contrôleur; 330 ohm; Vbh1; Vref; Vbh2; Vvert; Xor1; Xor2

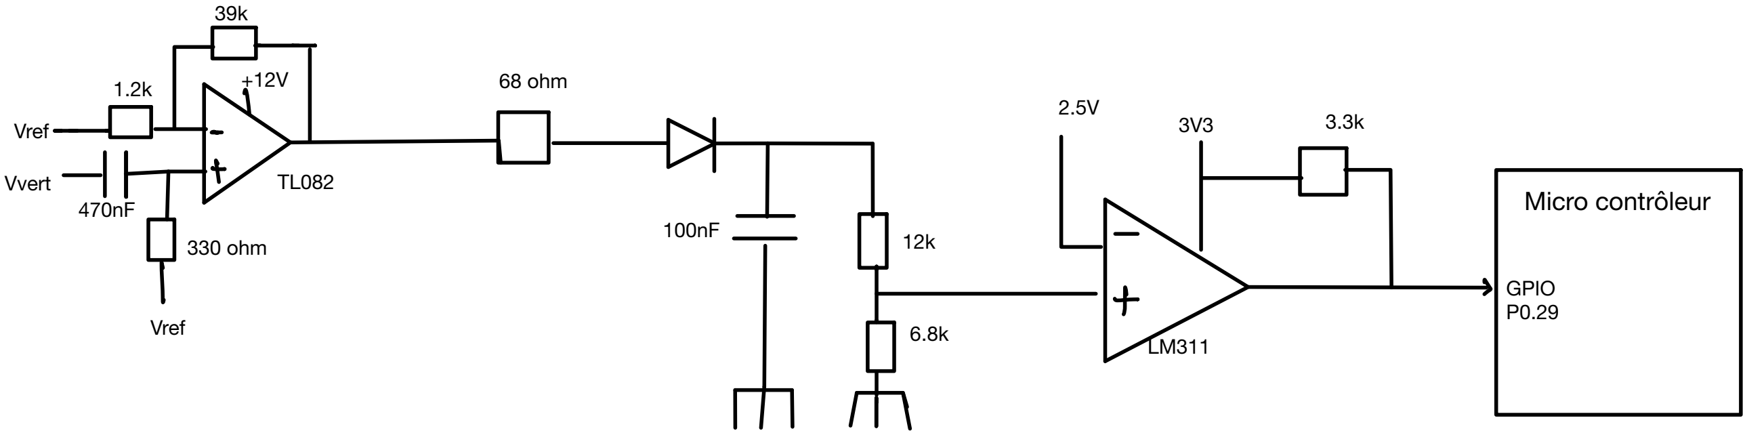
[picture p31: figure]
330 ohm; Vref; Vvert; 68 ohm; Micro contrôleur; GPIO P0.29
