AdhamHamdy03/Final-Project-Bachelor-DTMF-Ultrasound-Autonomous-Robot-etc-./(list of files, drawings)

Other design files:
schema et travail/reception_dtmf.opj
